fabriciogferreira/drone-with-esp2/Documentos/PRIMEIRO RELATÓRIO PARCIAL 2023.pdf

PRIMEIRO RELATÓRIO PARCIAL – PPD/2023 Envio até 15/05/2023

PPD/2023
Pesquisador:
Alunos bolsistas:
Alunos voluntários:
Colaboradores internos:
Colaboradores externos (incluir nome e instituição):
IDENTIFICAÇÃO DO PROJETO
Título: SIMULAÇÃO E CONTROLE DE ESTABILIDADE DE DRONES QUADRICÓPTEROS ATRAVÉS DE CONTROLE PID UTILIZANDO ARDUINO E ESP32
Área de Conhecimento:

( ) Ciências sociais e educação

( ) Biológicas e saúde

( X ) Agrárias, engenharias e tecnologia da informação.

COMITÊ DE ÉTICA EM PESQUISA COM HUMANOS (CEP) / COMITÊ DE ÉTICA

NO USO DE ANIMAIS (CEUA)

( ) Aprovado - CAAE: __________
( ) Em processo - CAAE: __________ ( ) Não enviado
( ) Não se aplica

1 – CRONOGRAMA DO PROJETO INICIAL

Conforme definido nas Tabelas 1 e 2, estão definidos em itens o cronograma proposto no

projeto entregue ao Programa de Pesquisa Docente 2023.

Este trabalho de pesquisa possui carácter interdisciplinar, onde iniciamos pelas

conceituações teóricas, análises matemáticas e desenvolvimento computacional, como forma de

definir e direcionar as sequências de opções mais adequadas e determinação de um melhor

resultado. Deste ponto em diante, os esforços estão na transposição das soluções teóricas e

virtuais para o sistema real, através das seguintes etapas:

a) Diagramação mecânica e cinemática da estrutura física do aeromodelo, suas características

sobre capacidade de sustentação e estabilidade.

Nesta etapa, o aluno deverá realizar o mapeamento de todas as variáveis do aeromodelo

tais como: peso dos componentes, peso do modelo completo, verificação da sustentação da

estrutura do quadricóptero por parte dos motores, velocidades mínimas e máximas atingidas.

Etapa concluída. Descrição na parte inicial do Desenvolvimento do Projeto.

b) Implementação do algoritmo de controle e sua utilização em plataforma de um grau de

liberdade.

Elaboração e implementação do algoritmo na plataforma Arduino e ESP-32 para controle

do protótipo com 1 grau de liberdade. Nesta etapa, utilizaremos somente 2 motores para a

estabilização.

Nesta etapa, foram implementados alguns algoritmos em C/C++ na plataforma Arduino para

controle dos motores.

c) Parametrização do algoritmo de interfaceamento sensores-microcontrolador.

Coleta dos valores dos parâmetros dos sensores do quadricóptero através da

implementação de algoritmo no Arduino e ESP-32.

d) Construção do circuito de desenvolvimento agregado ao microcontrolador, estrutura do

aeromodelo com quatro rotores e seus respectivos ESCs (Electronic Speed Controllers) e da

plataforma de teste para sustentação.

Elaboração e implementação do algoritmo na plataforma Arduino e ESP-32 para controle

do protótipo com 4 motores. Nesta etapa, utilizaremos os 4 motores para a estabilização e

definição do controle de velocidades.

e) Complementação da estrutura física para seus quatro rotores no modelo completo do

quadricóptero.

Construção do Chassi para agregação do circuito de controle, motores e sensores ao

quadricóptero.

f) Simulação em ambiente computacional e otimização das equações dinâmicas e seus

referentes coeficientes de ganho.

Mapeamento das variáveis para o equacionamento matemático do protótipo para a

estabilização através de controle PID.

g) Simulação em ambiente computacional, otimização do controle, seus referentes coeficientes

de ganho dos controladores.

Mapeamento das variáveis para otimização do controle do quadricóptero para a estabilização

e velocidade do modelo proposto.

h) Implementação do algoritmo de controle na plataforma do quadricóptero.

Implementação do programa em Arduino para o controle do quadricóptero em voo e

estabilização do conjunto proposto.

i) Análise de resultados e conclusão.

Apresentação dos resultados do projeto, da documentação da pesquisa e possíveis publicações

em congressos na área.

Tabela 1- Cronograma proposto no Projeto de Pesquisa Docente (Ano 1). ANO 1
Atividades | Fev. | Mar | Abr. | Mai | Jun. | Jul | Ago. | Set | Out | Nov. | Dez
a) Diagramação mecânica e cinemática da estrutura física do aeromodelo, suas características sobre capacidade de sustentação e estabilidade
b) Implementação do algoritmo de controle e sua utilização em plataforma de um grau de liberdade.
c) Parametrização do algoritmo de interfaceamento sensores-microcontrolador;
d) Construção do circuito de desenvolvimento agregado ao microcontrolador, estrutura do aeromodelo com quatro rotores e seus respectivos ESCs (Electronic Speed Controllers) e da plataforma de teste para sustentação.
e) Complementação da estrutura física para seus quatro rotores no modelo completo do quadricóptero;

Tabela 2 - Cronograma proposto no Projeto de Pesquisa Docente (Ano 2).

ANO 2

Atividades | Fev. | Mar | Abr. | Mai | Jun. | Jul | Ago. | Set | Out | Nov. | Dez
f) Simulação em ambiente computacional e otimização das equações dinâmicas e seus referentes coeficientes de ganho;
g) Simulação em ambiente computacional, otimização do controle, seus referentes coeficientes de ganho dos controladores;
h) Implementação do algoritmo de controle na plataforma do quadricóptero.
i) Análise de resultados e conclusão.

2 - HOUVE ALTERAÇÕES NO SEU PLANO DE TRABALHO (CRONOGRAMA)? QUAIS?
O cronograma inicial foi modificado devido a alteração do calendário proposto pelo Programa de Pesquisa Docente (PPD). As adaptações do novo cronograma estão definidas nas Tabelas 3 e 4.

Tabela 3- Cronograma modificado no Projeto de Pesquisa Docente (Ano 1).
ANO 1
Atividades | Fev. | Mar | Abr. | Mai | Jun. | Jul | Ago. | Set | Out | Nov. | Dez
a) Diagramação mecânica e cinemática da estrutura física do aeromodelo, suas características sobre capacidade de sustentação e estabilidade
b) Implementação do algoritmo de controle e sua utilização em plataforma de um grau de liberdade.
c) Parametrização do algoritmo de interfaceamento sensores-microcontrolador;
d) Construção do circuito de desenvolvimento agregado ao microcontrolador, estrutura do aeromodelo com quatro rotores e seus respectivos

ESCs | (Electronic | Speed
Controllers) e da plataforma de teste para sustentação.
e) | Complementação | da
estrutura física para seus quatro rotores no modelo
completo do quadricóptero;

Tabela 4- Cronograma modificado no Projeto de Pesquisa Docente (Ano 1). ANO 2
Atividades | Fev. | Mar | Abr. | Mai | Jun. | Jul | Ago. | Set | Out | Nov. | Dez
e) Complementação da estrutura física para seus quatro rotores no modelo completo do quadricóptero;
f) Simulação em ambiente computacional e otimização das equações dinâmicas e seus referentes coeficientes de ganho;
g) Simulação em ambiente computacional, otimização do controle, seus referentes coeficientes de ganho dos controladores;
h) Implementação do algoritmo de controle na plataforma do quadricóptero.
i) Análise de resultados e conclusão.

3 - ESTRUTURA DO RELATÓRIO, CONSIDERANDO O ART. 17º DO

REGULAMENTO DO PROGRAMA PESQUISADOR DOCENTE

A- INTRODUÇÃO

O município de Santa Fé do Sul está localizado extremo Noroeste Paulista, nas divisas de

Minas Gerais e Mato Grosso do Sul. Atualmente, o município é um dos 29 municípios paulistas

considerados estâncias turísticas, fortalecendo assim, a indústria do entretenimento, fazendo com

que milhares de turistas visitam a cidade todos os anos.

Santa Fé do Sul, também se encontra em uma das maiores regiões produtoras do setor

sucroalcooleiro e próxima ao Mato Grosso do Sul, hoje uma das maiores produtoras de papel e

celulose do país. Estas indústrias estão em crescente expansão e desenvolvimento, gerando

muitos empregos e riquezas para a região.

Para a supervisão e controle dos recursos turísticos, e plantio de cana-de-açúcar e

plantação eucalipto, da indústria de papel e celulose, podemos utilizar o monitoramento através

de Veículos Aéreos não Tripulados (VANTs) - drones.

Dada a crescente procura por derivados do setor sucroalcooleiro, como açúcar, etanol e

energia renovável, verifica-se a grande importância da cana-de-açúcar na economia brasileira. O

Brasil destaca-se como maior produtor mundial de cana-de-açúcar, com aproximadamente 640

milhões de toneladas processadas na safra de 2017/2018, de acordo com dados divulgados pela União da Indústria de Cana-de-Açúcar (ÚNICA, 2018), o que resultou em aproximadamente

38,69 milhões de toneladas de açúcar e 27,80 bilhões de litros de etanol para a agroindústria

sucroalcooleira (NOVACANA, 2017).

Com a expansão da cultura de cana-de-açúcar no país, aumentando eficiência,

produtividade e competitividade, e com o mercado sucroalcooleiro cada vez mais competitivo,

as usinas estão buscando novas alternativas para o desenvolvimento da produtividade agrícola,

de forma se estabelecer no mercado de forma competitiva.

Neste cenário de desenvolvimento da produtividade agrícola, os avanços em tecnologias

da informação e comunicação (TIC) estão cada vez mais presentes e sendo impactantes,

permitindo o armazenamento e processamento de grandes volumes de dados, automatização de processos e o intercâmbio de informações e de conhecimento (MASSRUHÁ; LEITE, 2016).

Observa-se atualmente uma forte relação do gerenciamento com a indústria 4.0, que representa

novos processos e produtos originados de avanços tecnológicos, com aplicações em várias áreas do conhecimento (SCHWAB, 2016; CONFEDERAÇÃO DA AGRICULTURA E PECUÁRIA

DO BRASIL, 2018).

Segundo Lopes (2018) e Simões; Soler; Py (2017), as transformações digitais também

chegaram nas atividades rurais, nas quais surge o termo agricultura 4.0, fortalecendo a ligação

urbano-rural nas suas diversas abordagens e permitindo dados cada vez mais precisos. A

agricultura 4.0 utiliza tecnologias de ponta na agricultura, incentivando processos na cadeia de

valor agregado da produção agrícola. Esta tecnologia pode ser uma importante revolução no

campo, tornando as lavouras mais eficientes e sustentáveis, bem como auxiliando a troca de informações e os processos com as empresas (SIMÕES; SOLER; PY, 2017).

As transformações digitais e a tecnologia aparecem no setor agrícola de várias formas. A

automação do processo, como da mão-de-obra, aconteceu com a ascensão de novas ferramentas, inovadoras e independentes (SIMÕES; SOLER; PY, 2017). Dentre os exemplos de tecnologias

e ferramentas utilizadas, encontram-se drones, caracterizados como os veículos aéreos não

tripulados (VANT), que são utilizados para monitoramento das lavouras, identificação de falhas

no plantio, entre outras atividades.

Segundo a Agência Nacional de Aviação Civil (ANAC, 2017), drones são aeronaves (ou

mesmo outro tipo de veículo) que possua alto grau de automatismo. A ANAC caracteriza as

aeronaves com finalidade comercial, corporativa ou experimental como Remotely Piloted

Aircraft (RPA - Aeronaves Remotamente Pilotadas).

O Sindicato Nacional das Empresas de Aviação Agrícola (SINDAG, 2017) supõem que

os drones serão substitutos de boa parte dos aparelhos de pulverização, trazendo precisão a

segurança na operação, ao mesmo tempo que coletam imagem em um raio maior do que seria

possível com acompanhamento da mão-de-obra na lavoura.

A tecnologias abortadas neste projeto são de interesse para a constante evolução das

indústrias do turismo, sucro-alcoleira e papel e celulose.

✓ JUSTIFICATIVA

A ênfase especial que os quadrimotores têm ganhado em cursos de Computação e

matérias de sistemas de controle robóticos, estendendo suas aplicações em usos militares, civis,

para observação, e até mapeamento de ambientes desconhecidos, é claramente justificável por

sua mobilidade aérea.

Para que um drone construído no formato de um quadrimotor possa realizar tarefas de

supervisão de ambiente torna-se necessário conhecer o posicionamento e orientação espacial,

para que o quadricóptero possa se movimentar neste ambiente.

Logo, a estabilidade do voo do quadricóptero é essencial para que ele possa ser utilizado,

impedindo que ele possa colapsar devido a uma forte corrente de vento, ou devido ao seu próprio

peso ou até mesmo devido informações com perturbações do empuxo resultante entre as hélices

do sistema. Para evitar estes problemas é necessário que se crie um sistema de controle capaz de

corrigir as variações devido às perturbações, reposicionando o drone na sua posição de equilíbrio com o menor tempo possível. O controle por PID (Proportional Integral Derivative -

Proporcional Derivativo e Integrativo) apresenta-se como uma solução de controle linear,

utilizado em várias aplicações na indústria de automação, sendo as vantagens deste método

segundo Leong (2012), possuir estrutura simples e bom desempenho.

Assim, tem-se como justificativa deste trabalho o estudo e confecção de um quadricóptero

com componentes comerciais, e a implementação de um algoritmo de controle computacional

baseado na teoria de sistemas lineares em um sistema dinâmico de estabilidade zero, como os

encontrados nos quadrimotores.

✓ PROBLEMATIZAÇÃO

Alguns estudos e trabalhos, como os de Beard (2008) e Zu, Zhang e Shan (2017),

dedicam-se à determinação de modelos matemáticos abrangentes e úteis aos problemas de

simulação e controle de quadrimotores. Outros, como o de Alves (2012) e Khatoon, Gupta e Das

(2014), dedicam-se ao estudo de técnicas para o controle deles, através do uso de técnicas de

controle lineares e não lineares.

Este trabalho se dedica ao desenvolvimento de estabilização de um drone com 4 motores,

envolvendo tanto o desenvolvimento de um protótipo, quanto a modelagem matemática dinâmica

do mesmo, o projeto dos controladores de estabilização de voo e o desenvolvimento do software

embarcado para controle do drone. Este trabalho também tem como objetivo ser open source, o

que permite sua replicação, e a um baixo custo, visto que os materiais utilizados foram

selecionados baseando-se em seus custos de mercado e nos requisitos mínimos impostos durante

a fase de desenvolvimento. O quadrimotor desenvolvido trata-se de um drone em formato de cruz

com dois pares de rotores que rotacionam em sentidos opostos a fim de eliminar os torques

gerados.

Diferentes controladores para a estabilização de voo de quadrimotores existem, lineares

e não lineares, este trabalho visa estabelecer um comparativo entre os resultados obtidos e

compará-los com os métodos já elaborados na literatura. Os controladores lineares desenvolvidos

utilizarão técnicas conhecidas como PID (Proportional Integral Derivative - Proporcional

Integral e Derivativo) (Ogata, 2011).

✓ OBJETIVOS

- OBJETIVO GERAL

Este trabalho de pesquisa tem por objetivo a construção completa de um protótipo

do tipo quadricóptero, implementar o controle dos sensores e o equacionamento de seu

algoritmo de controle PID, tornando o drone deste projeto, ser capaz de manter voo com a

melhor estabilidade.
- OBJETIVOS ESPECÍFICOS

Os objetivos específicos definidos na proposta deste trabalho são:

a) Levantamento e equacionamento dinâmico do VANT do tipo quadricóptero.
b) Construção de um algoritmo de controle em Arduino utilizando lei de controle

PID.

c) Construção da estrutura (chassi) do quadricóptero.
d) Aquisição e análise de dados pelos sensores utilizados.
e) Simulação utilizando os parâmetros do modelo desenvolvido.
f) Implementação do algoritmo de controle e aplicação no protótipo construído.

B – METODOLOGIA

Foram realizadas pesquisas em livros, artigos científicos e periódicos para conhecimento

e aprofundamento do tema.

Este trabalho de pesquisa possui carácter interdisciplinar, onde iniciamos pelas

conceituações teóricas, análises matemáticas e desenvolvimento computacional, como forma de

definir e direcionar as sequências de opções mais adequadas e determinação de um melhor

resultado. Deste ponto em diante, os esforços estão na transposição das soluções teóricas e

virtuais para o sistema real, através das seguintes etapas:

a) Diagramação mecânica e cinemática da estrutura física do aeromodelo, suas

características sobre capacidade de sustentação e estabilidade;

b) Implementação do algoritmo de controle e sua utilização em plataforma de um grau de

liberdade;

c) Parametrização do algoritmo de interfaceamento sensores-microcontrolador;

d) Construção do circuito de desenvolvimento agregado ao microcontrolador, estrutura

do aeromodelo com quatro rotores e seus respectivos ESCs (Electronic Speed Controllers

– Controladores Eletrônicos de Velocidade) e da plataforma de teste para sustentação;

e) Complementação da estrutura física para seus quatro rotores no modelo completo do

quadricóptero;

f) Simulação em ambiente computacional e otimização das equações dinâmicas e seus

referentes coeficientes de ganho;

g) Simulação em ambiente computacional, otimização do controle, seus referentes

coeficientes de ganho dos controladores;

h) Implementação do algoritmo de controle na plataforma do quadricóptero;
i) Análise de resultados e conclusão.
- MATERIAL | E | REQUISITOS | TÉCNICOS | NECESSÁRIOS | PARA | O

DESENVOLVIMENTO DO PROJETO

✓ MATERIAIS UTILIZADOS

Para a implementação do projeto foram utilizados softwares gratuitos e de código aberto

para o desenvolvimento da aplicação. Assim, não sendo necessários a aquisição de licenças

de softwares privados.

Para a confecção do drone da pesquisa, serão utilizados os seguintes componentes:

ESP32, ESP32-CAM, Módulo Giroscópio com Acelerômetro 3 eixos, 1 Bateria URUAV

11.1V Lipo, 4 Motores Brushless 2300 kV e 4 Placas ESC – 30 A. Todos os materiais já

foram adquiridos para a realização da pesquisa científica.
✓ REQUISITOS TÉCNICOS NECESSÁRIOS

Conhecimentos em Engenharia de Software, Programação de Computadores,

Arquitetura de Computadores, Matemática Básica e Física.

Este Projeto de Pesquisa Docente (PPD) deseja estudar e apresentar soluções relevantes

sobre a possibilidade de se aplicar o conhecimento adquiridos no curso de Análise e

Desenvolvimento de Sistemas, para o equacionamento, implementação e construção de um

quadricóptero de baixo custo.

Devido à complexidade da dinâmica envolvida no somatório de fenômenos físicos que

variam ao longo do tempo, pode-se perceber que o equacionamento de voo deste sistema,

depende de um controle de múltiplos níveis e não estacionário. Este tipo de planta, para ter

sua solução ótima, demanda da linearização do sistema e da implementação de um controle

robusto.

Algumas literaturas recentes, citam técnicas de inteligência artificial, como

possibilidades de soluções que poderiam alcançar a adaptação necessária ao controle de um

sistema que possui variação de parâmetros e equações em função do tempo. Sistemas que

utilizam técnicas que realizam o recálculo de seus parâmetros, e que as reutilizam como

forma de aprendizado, têm maiores chances de alcançar o controle eficaz de um sistema não

estacionário. Estas técnicas de programação podem ser exemplificadas pelo estudo das redes

neurais, nebulosas, grafos, genéticos e Fuzzy, como descrito por este artigo da Universidade

do Tehran:

Embora o quadrirotor tenha vantagens em uma construção mecânica fácil contra o

helicóptero tradicional, ainda há questões que impedem que ele seja amplamente utilizado

em muitos dos campos sugeridos de aplicação. Por exemplo, o controle e orientação do

quadrirotor para estabilização, é uma tarefa difícil, devido ao comportamento dinâmico não

linear. Métodos de controle convencionais usam teoria linear que é adequado apenas para

sistemas lineares. O controle Fuzzy é não-linear, portanto, é adequado para o controle do

sistema não-linear (ABBASI; MAHJOOB; YAZDANPANAH, 2013).

Contudo, algoritmos metaheuríticos (como por exemplo Algoritmos Evolutivos ou

Genéticos) atuam em espaços de busca relativamente grandes e exigem alta precisão no

computar das operações, para muitos casos. Nos casos de algoritmos de inteligência artificial,

o problema de custo computacional (processamento) é ainda maior, já que as operações são

computacionalmente intensas e exigem altas taxas de leitura e escrita em memória. Esse

poder computacional não é totalmente disponível nos processadores e sistemas de

embarcados em VANTs. Além disso, operações computacionalmente intensas aumentam o

consumo de energia diminuindo a autonomia de voo.

Assim, existem várias formas de se controlar a estrutura PID original, de forma que estas

também podem reagir e se adaptarem às mudanças do ambiente em que se encontra. A técnica

Feedforward de PID pode ser empregada com este intuito, em um sistema que seja possível variar

o sinal de controle em um tempo menor que o tempo que um distúrbio leva para afetar a saída,

quantificar os distúrbios do sistema e, os efeitos desses distúrbios na resposta depois das análises

dos sensores. Assim, este trabalho tem por objetivo, implementar um algoritmo em Arduino e

ESP-32 utilizando o controle PID de forma a viabilizar a estabilização do voo de um drone.

C – DESENVOLVIMENTO DO PROJETO
1 - CONSIDERAÇÕES INICIAIS

Os drones usam rotores para propulsão e controle. Eles foram projetados de forma que as

hélices empurram o ar para baixo. Como as forças vêm em pares, quando o rotor empurra o ar

para baixo, o mesmo ar empurra o drone para cima. Assim, quanto mais rápido os rotores giram,

maior será a força gerada para subir (ZARDO; REIS; WEBBER, 2021).

Um drone pode executar ações úteis para a compreensão dos fenômenos físicos

relacionados a força gravitacional, movimento, aceleração, inércia e rotação. Para exemplificar,

a física do drone funciona com os quatro rotores, que estão empurrando o drone para cima,

igualando-se à força gravitacional. Para subir, a velocidade dos rotores deve ser aumentada,

produzindo uma força ascendente maior que o peso do próprio drone.

Para descer, deve-se diminuir o impulso aos poucos para que a força da gravidade

empurre o drone para baixo. Para os movimentos de deslocamento e rotação, os rotores precisam

ser coordenados para atuarem em diferentes velocidades, gerando os movimentos desejados do

protótipo elaborado (ZARDO; REIS; WEBBER, 2021).

- Movimentação Vertical: Os motores são separados da seguinte forma: Sendo

que os motores 1-3 sempre rodando em sentido horário e os motores 2-4 em

sentido anti-horário. Com os motores rodando as hélices na mesma velocidade e

com as rotações dessa forma, o momento angular do drone será completamente 0,

como pode observar na Figura 1, (BRAGA, 2013).

Figura 1 – Posição de rotação dos motores

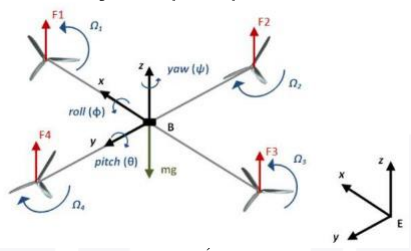
[picture p1: figure]

Fonte: (SÁ, 2012).

- Movimentação: Para a movimentação para frente, a força dos motores Traseiros

(3 e 4) tem que aumentar enquanto a força de rotação dos Dianteiros (1 e 2) tem

que diminuir. Para ele se movimentar para trás o mesmo processo com as forças

invertidas, sendo os traseiros os mais fracos, e os mais fortes, os dianteiros. Pelo

fato dos motores traseiros e dianteiros serem um com rotação horário e um anti-

horário, o momento angular do drone continua sendo 0, porém podendo ir para

frente ou trás, sem rodar (BRAGA, 2013).

Na Figura 1 são ilustrados os movimentos possíveis, nela a largura da seta é proporcional

à velocidade dos rotores. Os motores 1 e 3 giram em sentido anti-horário e os motores 2 e 4 giram

em sentido horário (MIRANDA, 2019).

Fixando a velocidade dos motores 2 e 4 e aumentando a velocidade do motor 3 em relação

a velocidade do motor 1 o quadrimotor se move para frete, como mostrado na Figura 2. O

contrário ocorre quando a velocidade do motor 3 é maior que a velocidade do motor 1, Figura 2

(b). Os movimentos para direita e esquerda ocorrem quando a velocidade dos motores 1 e 3

permanece a mesma e a velocidade do motor 2 varia em relação a velocidade do motor 4, Figura

2 (c) e 2 (d) (MIRANDA, 2019).

Figura 2 – Posição de rotação dos motores

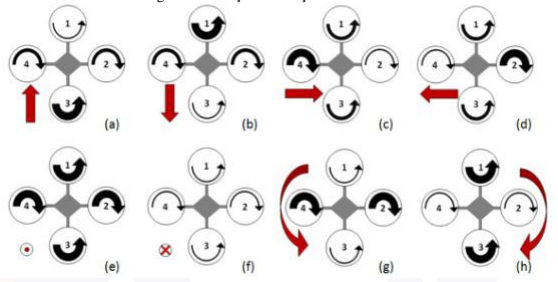
[picture p2: figure]

Fonte: (SÁ, 2012)

O aumento ou a diminuição da velocidade igualmente nos quatro motores faz com que o

quadrirotor se mova verticalmente. De acordo com Sá (2012), com o aumento simultâneo de

todas as velocidades angulares dos rotores o quadrirotor se move para cima e a diminuição

simultânea de todas as velocidades faz com que se mova para baixo, conforme Figura 1 e 2.

A variação de dois rotores situados no mesmo eixo produz um torque em torno do eixo

gerando uma aceleração angular. Então, se os dois rotores que giram em sentido anti-horário

(rotores 1 e 3) aumentarem suas velocidades angulares e os rotores 2 e 4 permanecessem com

velocidade menor, o torque produzido na plataforma faria com que ele gire em sentido horário,

como mostrado na Figura 2(h). O contrário ocorreria se aumentassem os rotores 2 e 4 em relação

aos rotores 1 e 3, Figura 2 (g).

1.1 – CÁLCULO PID

Para manter a estabilidade do drone no ar, é de extrema importância utilizar um cálculo

PID para atualizar os valores de potência dos motores automaticamente, assim o piloto gozará de

maior liberdade no controle do VANT. O cálculo PID é relativamente simples, funcionando da

seguinte forma:

- P - representa o valor proporcional, simplificando seria o valor que controla a potência

de reação dos motores, o que faz o drone sair do chão.

- I - representa o valor integral, simplificando é a intolerância ao desnível, onde a leitura

da posição atual é diferente da do valor esperado (setpoint), forçando o motor a trabalhar para

alcançar a estabilidade.

- D - representa o valor derivativo, sua função é desacelerar o valor proporcional quando

estiver se aproximando do setpoint, para assim não ultrapassar o valor inicial, evitando o

fenômeno conhecido como overshoot, um erro de divergência que atrasa a correção do valor da

posição.

Para melhor visualização do funcionamento do cálculo, observe a Figura 3, que utiliza os

dados obtidos através do giroscópio para o controle, em seguida analisa as diferenças entre eles

e o setpoint, sendo este valor o erro “e(t)”, que é utilizado nas equações representadas resultando

no sinal de controle “u(t)”, este sinal de controle por sua vez será utilizado no controle de

processo utilizando uma representação matemática do sistema, normalmente diferencial, para só

assim controlar o processo e alcançar o valor desejado para a saída “y” (setpoint). Por fim, a

saída do processo lida mediante a malha de realimentação “y” é subtraída do setpoint resultando

no sinal de erro “e(t)”, resultando assim em um looping que constantemente corrige a posição do

drone, mantendo assim a estabilidade aérea.

Todas as informações descritas estão de acordo com Anon (2016a), consta com

adaptações no projeto feitas pelos próprios autores para melhor compreensão do leitor.

Figura 3 – Alimentação e conexão da controladora com os ESCs

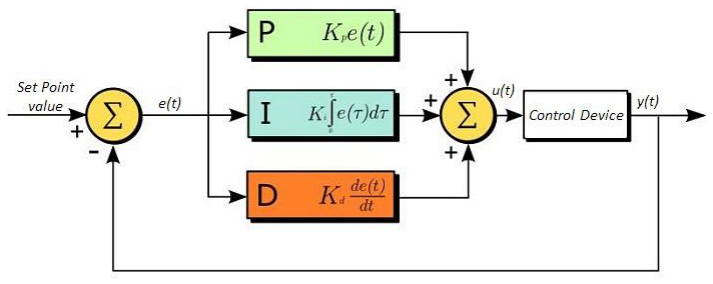
[picture p3: figure]

Fonte: (ANON, 2016b)

Na primeira etapa do projeto, optou-se pela aquisição de um chassi pronto, conforme

apresentado na Figura 4.

Figura 4 – Chassi do Drone

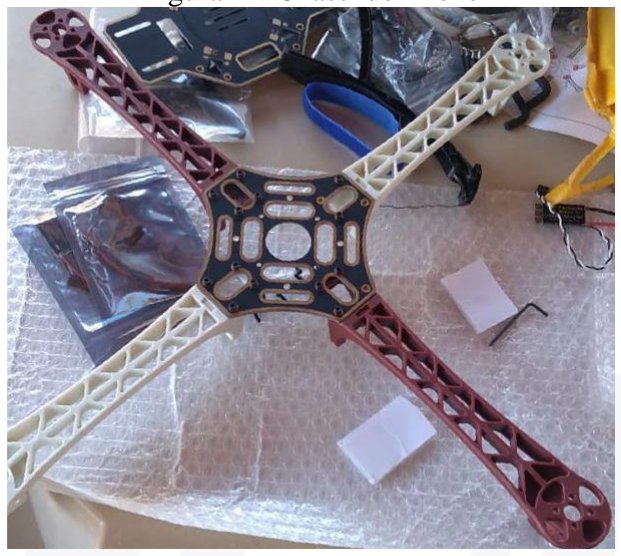
[picture p4: figure]

Fonte: Próprios autores.

Com a chegada das peças iniciou-se o processo de montagem do drone físico, para assim dar

início aos testes que os programas carecem. Primeiramente, montou-se o chassi de acordo com

o mapa fornecido pelo vendedor, como é apresentado na Figura 4. Em seguida, foram soldados

os componentes e feito teste de continuidade com o multímetro para verificar se alguma trilha da

placa estava corrompida como mostra a Figura 5.

Figura 5 – Soldagem dos Motores e Conector da Bateria

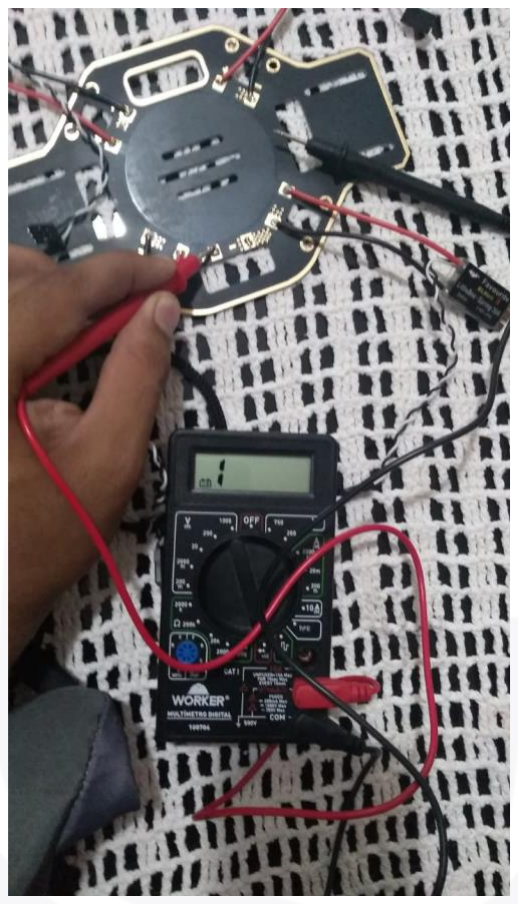
[picture p5: figure]

Fonte: Próprios autores.

Finalizado a etapa de pesquisas e compras, iniciou-se os testes de software e hardware,

para assim constatar se a comunicação estava funcionando e o controle cumprindo com suas

obrigações, o teste foi concluído com êxito onde se vê claramente o trabalho de sintonia entre a

parte lógica e física do projeto.

1.2 - PLACA PCB COM INTERRUPTOR

Foi adaptado um interruptor ao chassi, o prendendo com cola quente, isto foi feito com o

intuito de permitir ligar e desligar o drone para testes de forma mais rápida e simples, pois, se

isso não fosse feito, teríamos que sempre ficar conectando e desconectando os pinos macho e

fêmea do conector XT60. Mesmo sendo um interruptor de boa qualidade estando desligado ele

permite que passe uma tensão de aproximadamente de 0.8V, por conta disso, quando os testes forem parados é aconselhável desconectar o pino da bateria do pino do chassi, como pode-se

observar na Figura 6.

Figura 6 – Adaptação do Botão Tic-Tac

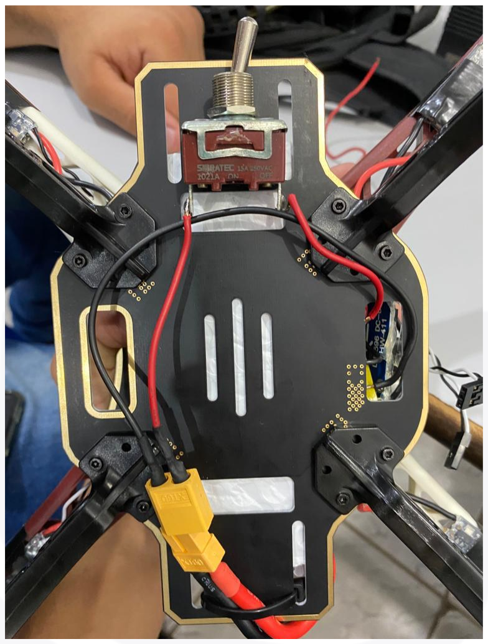
[picture p6: figure]

Fonte: Próprios autores.

1.3 - BRAÇO COM MOTOR E ESC

Neste braço, como nos outros, foi preso em sua ponta um motor sem escova rs2205

2300kv 2205 cW/ccW, ele foi preso com parafusos que vieram junto com o conjunto do chassi

que compõem o módulo. Para fazer o controle desse tipo de motor precisamos utilizar um ESC

(Eletronic Speed Controller, Controlador Eletrônico de Velocidade) o qual foi preso na parte de

baixo do braço com seus terminais soldados na placa de baixo do chassi - placa PCB (Printed

Circuit Board - Placa de Circuito Impresso) onde estão presos os pés do drone – e seus pinos de

controle, onde será recebido o pulso PWM (Pulse Width Modulation – Modulação com largura

de pulso), será preso na placa de controle, como pode-se observar na Figura 7.

Figura 7 – Braço com Motor e ESC

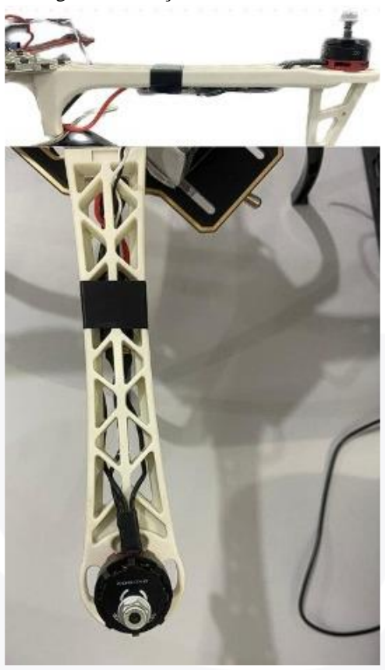
[picture p7: figure]

Fonte: Próprios autores.

1.4 - FIXAÇÃO DAS PLACAS AO CHASSI
Para terminar a montagem do drone em si, bastava anexar a placa de controle e o servidor

web ESP32-CAM ao drone. Portanto, para o ESP32-CAM foi utilizado fita dupla face e uma

cinta de velcro azul que veio junto com a compra do chassi. Já para colocar a placa de controle

foi utilizado fita dupla face e para evitar o contato da parte eletrônica que fica embaixo da placa

de controle com a parte metálica do chassi, foi anexado entre ambos um pedaço de papelão –

preso à placa com cola quente – e preso ao papelão a dupla face que o fixou ao chassi, como pode

observar nas Figuras 8 e 9.

Figura 8 – Fixação das hélices | Figura 9 – Fixação das placas ao Chassi

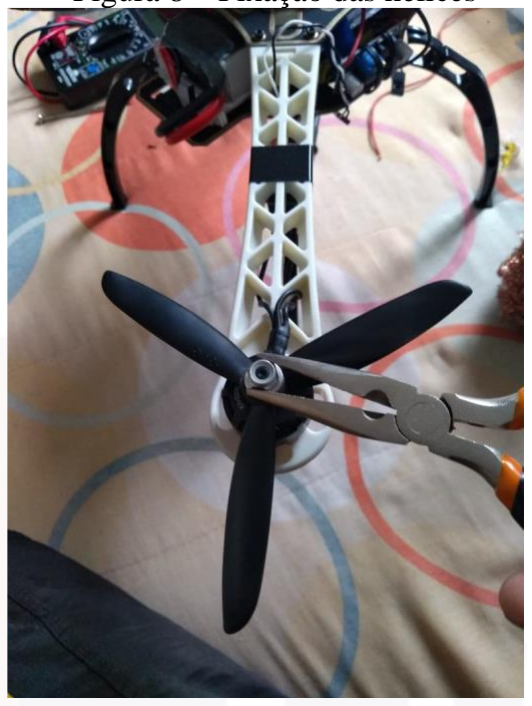
[picture p8: figure]
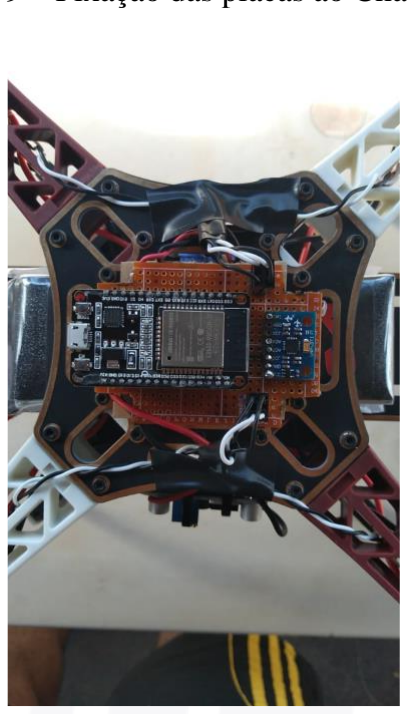
[picture p9: figure]

Fonte: Próprios autores.

1.5 - ALIMENTAÇÃO E CONEXÃO DA CONTROLADORA COM OS ESCS

Após prender as duas placas foi realizado a parte de alimentação de ambas, onde foi

soldado a placa os terminais de saída do regulador de tensão que envia para placa uma tensão de

5V. Da placa, a energia é enviada para o ESP32 – por meio de fios soldados aos terminais GND

e VIN – e para o ESP32-CAM – conectado a um cabo micro-usb que tem seus terminais

conectados aos pinos GND e VIN do ESP32. Também foi feita a conexão entre a placa de

controle e os ESCs, onde cada pino de entrada de dados de cada ESC foi colocado em cada

terminal específico, como pode observar a Figura 10.

Figura 10 – Alimentação e conexão da controladora com os ESCs

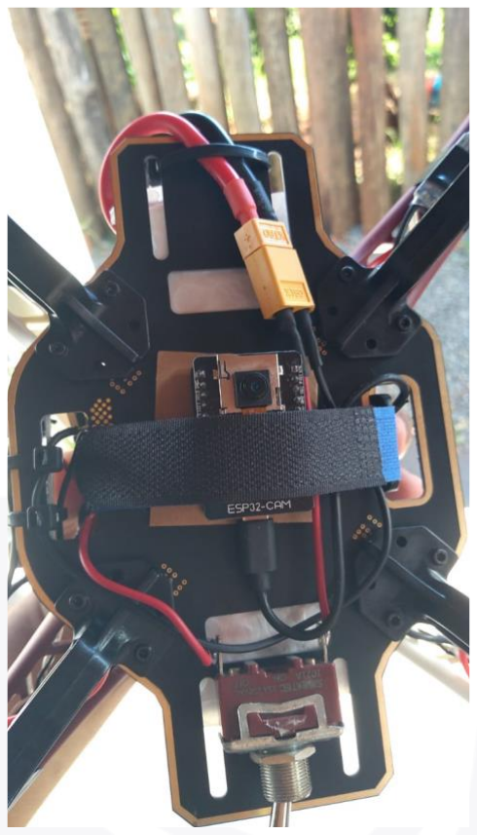
[picture p10: figure]

Fonte: Próprios autores.

1.6 – CONSIDERAÇÕES FINAIS

No próximo relatório dar-se-á ênfase os algoritmos e componentes eletrônicos utilizados na

etapa (b) do cronograma. A junção dos itens propostos no cronograma deste relatório, definirá a

composição do texto desta pesquisa científica.

REFERÊNCIAS BIBILIOGRÁFICAS

ABBASI E.; MAHJOOB M. J.; YAZDANPANAH R. Controlling of Quadrirotor UAV Using a Fuzzy System for Tuning the PID Gains in Hovering Mode. School of Mechanical Engineering, University of Tehran, Iran, 2013.

ALVES, Ana Sophia Cavalcanti. Estudo e Aplicação de Técnicas de Controle Embarcadas para Estabilização de Voo de Quadricópteros, 2012, 121 f. Tese (Doutorado em Engenharia Elétrica) – Universidade Federal de Juiz de Fora.

ANAC, 2017. Regras sobre drones. Disponível em: http://www.anac.gov.br/noticias/2017/regras-da-anac-para-uso-de-drones-entram-em-vigor/release_drone.pdf. Acesso em: 20 de Dez. 2022.

ANON. Controlador PID. Você sabe o que é e como funciona? Aula 01 - Teoria. 2016. Url https://www.youtube.com/watch?v=MPkEPvs8rec.

ANON. CONTROLADORES PID. 2016. Url https://smarti.blog.br/controladores-pid/.

BEARD, R. W. Quadrotor Dynamics and Control, 2008.

BRAGA, A. P. Simulação e controle de um quadcopter utilizando lógica fuzzy. Universidade Estadual Paulista (Unesp), 2013.

KHATOON, S; GUPTA, D.; DAS, L. K. PID & LQR Control for a Quadrotor: Modeling and Simulation, IEEE Robotics & Automation Magazine, 2014.

LEONG, Bernard Tat Meng; LOW, Sew Ming; OOI, Melanie Po-Leen. Low-Cost Microcontroller-based Hover Control Design of a Quadcopter. Procedia Engineering. V. 41,
p. 458-464, 2012.

LOPES, M. A. Agricultura 4.0: o agronegócio também na rota do desenvolvimento tecnológico. 2018. Disponível em: https://www.techminds.info/2018/05/10/agricultura-4-0-oagronegocio-tambem-na-rota-do-desenvolvimento-tecnologico. Acesso em: 02 de Jan. 2023.

MASSRUHÁ, S. M. F. S.; LEITE, M. A. A. Agricultura Digital. RECoDAF – Revista Eletrônica Competências Digitais para Agricultura Familiar, Tupã, v. 2, n. 1, p. 72-88, jan./jun. 2016.

MIRANDA, B. d. A. S. Montagem de uma plataforma para testes de controle de um veículo aéreo não tripulado quadrimotor. Dissertação (B.S. thesis) — Universidade Tecnológica Federal do Paraná, 2019.

NOVACANA, 2017. Conab divulga dados finais de 2016/17 e 1º levantamento da safra 2017/18 de cana-de-açúcar. Disponível em: https://www.novacana.com/n/cana/safra/conabdados-finais-2016-17-levantamento-safra-2017-18-cana-de-acucar-180417/. Acesso em: 10 Jan. 2023.

OGATA, K. Engenharia de Controle Moderno. 5th ed. 2011.

SÁ, R. C. Construção, modelagem dinâmica e controle PID para estabilidade de um veículo aéreo não tripulado do tipo quadrirotor. 2012.

SCHWAB, K. The Fourth Industrial Revolution, WEF, 2016.

SIMÕES, M.; SOLER, L; S.; PY, H. Tecnologias a serviço da sustentabilidade e da agricultura. Boletim informativo da SBCS. Mai-ago, 2017.

SINDAG, 2017. Relatório de Atividades – Brasil 2016. Disponível em: http://sindag.org.br/wp-content/uploads/2016/12/SINDAG-Relatorio-de-Atividades-Abril2016.pdf.

UNICA, 2018. Relatório final da safra 2017/2018. Disponível em: http://www.unicadata.com.br/listagem.php?idMn=102.

ZARDO, M.; REIS, C. E. R. dos; WEBBER, C. G. Como um drone voa? descubra na aula de física! RENOTE, v. 19, n. 2, p. 292–301, 2021.

ZU, Y.; ZHANG, W.; SHAN J. A trajectory design method for quadrotor based on DMOC method and Dubins path algorithm, 36th Chinese Control Conference, 2017.
