fabriciogferreira/drone-with-esp2/Códigos/Control/Control.ino

//===================================================================================
//====================================|VARIABLES|====================================
//===================================================================================
//------------------------------------|LIBRARIES|------------------------------------
  #include <WiFi.h>
  #include <Wire.h>
  #include <esp_now.h>
  #include <SPI.h>
  #include <Adafruit_GFX.h>
  #include <Adafruit_SSD1306.h>

//----------------------------------|COMUNICATION|-----------------------------------
  struct ControlData {
    int dof[3];
    int throttle;
    volatile bool flightMode;
  };

  ControlData controlData = {{0, 0, 0}, 0, true};

  struct DroneData {
    enum Errors {
      NOT_ERROR = 0,
      MPU6050_ERROR = 1,
    };

    Errors error;
    unsigned int speed;
    float angles[3];
    float pwmSignalInUs[4];
    float angularVelocities[3];
  };

  DroneData droneData = {DroneData::NOT_ERROR, 0, {0, 0, 0}, {0, 0, 0, 0}, {0, 0, 0}};

  const uint8_t SLAVES_MAC_ADDRESSES[][6] = {
    // { 0xCC, 0xDB, 0xA7, 0x30, 0x46, 0x34 }  //Mac address do meu ESP32 para o drone
    { 0xD0, 0xEF, 0x76, 0x33, 0x33, 0xC0 }  //Mac address do ESP32 do professor para o drone
  };

  const unsigned int CHANNEL = 1;  //Canal do slave
  const unsigned int AMOUNT_OF_SLAVES = sizeof(SLAVES_MAC_ADDRESSES) / 6; //Quantidade de ESP Escravos, os que vão receber dados

//-------------------------------------|DISPLAY|-------------------------------------
  #define SCREEN_WIDTH 128 // OLED display width, in pixels
  #define SCREEN_HEIGHT 64 // OLED display height, in pixels

  // Declaration for an SSD1306 display connected to I2C (SDA, SCL pins)
  // The pins for I2C are defined by the Wire-library. 
  #define OLED_RESET     -1 // Reset pin # (or -1 if sharing Arduino reset pin)
  #define SCREEN_ADDRESS 0x3C ///< See datasheet for Address; 0x3D for 128x64, 0x3C for 128x32
  Adafruit_SSD1306 Display(SCREEN_WIDTH, SCREEN_HEIGHT, &Wire, OLED_RESET);

//-------------------------------------|CONTROL|-------------------------------------
  //DOF = Degrees Of Freedom
  //J1x, J1y, J1z, J2x, J2y, J2z
  const unsigned int PIN_YAW = 35;
  const unsigned int PIN_THROTTLE = 34;
  const unsigned int PIN_J1Z = 25;
  const unsigned int PIN_ROLL = 33;
  const unsigned int PIN_PITCH = 32;
  const unsigned int PIN_J2Z = 26;

  const unsigned int *PT_PINS_XY_JS[] = {&PIN_YAW, &PIN_THROTTLE, &PIN_ROLL, &PIN_PITCH};
  const int MIN_SETPOINTS[] = {-30, 950, -30, 30};
  const int MID_SETPOINTS[] = {0, 1525, 0, 0};
  const int MAX_SETPOINTS[] = {30, 1800, 30, -30};
  unsigned int maxRangeOfJoystickAxes[] = {0, 0, 0, 0};
  unsigned int midRangeOfJoystickAxes[] = {0, 0, 0, 0};
  unsigned int minRangeOfJoystickAxes[] = {UINT_MAX, UINT_MAX, UINT_MAX, UINT_MAX};
  const unsigned int JOYSTICK_AXIS_DEAD_ZONE_RATES[] = {10, 10, 10, 10};
  unsigned int joystickAxisDeadZones[] = {0, 0, 0, 0};

  int *SetPoints[] = {&controlData.dof[0], &controlData.throttle, &controlData.dof[1], &controlData.dof[2]};

  int pinJ1ZState = HIGH;            // DEVE SER O VALOR CONSTANTE DO BOTÃO
  int lastPinJ1ZState = pinJ1ZState; 
  unsigned long j1ZLastDebounceTime = 0;  // the last time the output pin was toggled
  const unsigned int J1Z_DEBOUNCE_DELAY = 50;

  int pinJ2ZState = HIGH;            // DEVE SER O VALOR CONSTANTE DO BOTÃO
  int lastPinJ2ZState = pinJ2ZState; 
  unsigned long j2ZLastDebounceTime = 0;  // the last time the output pin was toggled
  const unsigned int J2Z_DEBOUNCE_DELAY = 50;

//--------------------------------------|UTILS|--------------------------------------
  bool stop = true;
//===================================================================================
//======================================|CODE|=======================================
//===================================================================================
//--------------------------------------|UTILS|--------------------------------------
  template<typename T, int N>
  int getArraySize(T (&array)[N]) {
    return N;
  }

  void printOnDisplay(String text, bool resetCursor = NULL, int delayTime = 0, bool clearDisplay = NULL){
    if (clearDisplay) Display.clearDisplay();
    if (resetCursor) Display.setCursor(0,0);
    Display.println(text);
    Display.display();
    if (delayTime) delay(delayTime);
  }

void startSerial(){
  Serial.begin(115200);
}

void configDisplay(){
  Display.begin(SSD1306_SWITCHCAPVCC, SCREEN_ADDRESS);
  Display.setCursor(0,0);
  Display.setTextSize(1);
  Display.setTextColor(SSD1306_WHITE);
  Display.clearDisplay();
}

void configJoystick(){
  printOnDisplay("Configurando joysticks", true, 1000, true);
  for (int i = 0; i < getArraySize(PT_PINS_XY_JS); i++) {
    pinMode(*PT_PINS_XY_JS[i], INPUT);
  }

  pinMode(PIN_J2Z, INPUT);
}

void readJ1Z(){
  int state = digitalRead(PIN_J1Z);
  
  if (state != lastPinJ1ZState) {
    j1ZLastDebounceTime = millis();
  }

  if ((millis() - j1ZLastDebounceTime) > J1Z_DEBOUNCE_DELAY) {
    if (state != pinJ1ZState) {
      pinJ1ZState = state;
      if (pinJ1ZState == HIGH) controlData.flightMode = !controlData.flightMode;
    }
  }

  lastPinJ1ZState = state;
}

void readJ2Z(){
  int state = digitalRead(PIN_J2Z);

  if (state != lastPinJ2ZState) {
    j2ZLastDebounceTime = millis();
  }

  if ((millis() - j2ZLastDebounceTime) > J2Z_DEBOUNCE_DELAY) {
    if (state != pinJ2ZState) {
      pinJ2ZState = state;
      if (pinJ2ZState == HIGH) { stop = !stop;}
    }
  }

  lastPinJ2ZState = state;
}

void stopUntilPressToContinue(String text){
  printOnDisplay(text);

  while (stop){
    readJ2Z();
  };
}

void resetStop(){
  stop = true;
}

void getRangeOfJoystickAxes(){
  printOnDisplay("Mova os joysticks em todas as direções", true, 0, true);

  stopUntilPressToContinue("Aperte R3 para prosseguir");

  resetStop();

  int value = 0;

  do{
    Display.clearDisplay();
    Display.setCursor(0,0);

    for (int i = 0; i < getArraySize(PT_PINS_XY_JS); i++) {
      value = analogRead(*PT_PINS_XY_JS[i]);
      if(value > maxRangeOfJoystickAxes[i]){
        maxRangeOfJoystickAxes[i] = value;
      } else if (value < minRangeOfJoystickAxes[i]) {
        minRangeOfJoystickAxes[i] = value;
      }

      printOnDisplay(String(*PT_PINS_XY_JS[i]) + ": " + String(minRangeOfJoystickAxes[i]) + " - " + String(maxRangeOfJoystickAxes[i]));
    }
    
    readJ2Z();
  }while(stop);
}

void getAverageOfJoystickAxes(){
  printOnDisplay("Calculando o meio dos eixos dos joysticks", true, 0, true);

  int max = 3000;
  for (int i = 0; i < max; i++) {
    for (int j = 0; j < getArraySize(PT_PINS_XY_JS); j++) {
      midRangeOfJoystickAxes[j] = midRangeOfJoystickAxes[j] + analogRead(*PT_PINS_XY_JS[j]);
    }
    // delayMicroseconds(20);
  }

  for (int i = 0; i < 4; i++) {
    midRangeOfJoystickAxes[i] = midRangeOfJoystickAxes[i]/max;
    printOnDisplay(String(*PT_PINS_XY_JS[i]) + ": " + String(midRangeOfJoystickAxes[i]));
  }
}

void getDeadZonesOfJoystickAxes(){
  printOnDisplay("Deadzone dos eixos dos joysticks", true, 0, true);

  for (int i = 0; i < 4; i++) {
    joystickAxisDeadZones[i] = JOYSTICK_AXIS_DEAD_ZONE_RATES[i] * midRangeOfJoystickAxes[i] / 100;

    printOnDisplay(String(*PT_PINS_XY_JS[i]) + ": " + String(midRangeOfJoystickAxes[i] - joystickAxisDeadZones[i]) + " - " + String(midRangeOfJoystickAxes[i] + joystickAxisDeadZones[i]));
  }
}

void startStationMode() {
  WiFi.mode(WIFI_STA);

  printOnDisplay("Inicializando o modo station", true, 0, true);
  printOnDisplay("Mac Address desse ESP em Station: " + WiFi.macAddress());
}

void startEspNow() {
  bool Result = esp_now_init() == ESP_OK;

  String message = Result ? "ESPNow iniciado com sucesso." : "Não foi possível iniciar o ESPNow.";
  
  printOnDisplay(message, true, 0, true);

  if (!Result) {ESP.restart();}
}

void registerFunctionThatExecutesWhenReceivingResponse(){
  esp_now_register_send_cb(WhenReceivingResponseDo);
}

void registerFunctionThatExecutesWhenReceivingData(){
  esp_now_register_recv_cb(WhenReceivingDataDo);
}

void establishConnectionBetweenESPs(){
  printOnDisplay("Configurando Master (Mestre) e Escravos (Slaves)...", true, 500, true);

  for (int i = 0; i < AMOUNT_OF_SLAVES; i++) {
    esp_now_peer_info_t Slave = {};
    Slave.channel = CHANNEL;
    Slave.encrypt = 0;
    memcpy(Slave.peer_addr, SLAVES_MAC_ADDRESSES[i], sizeof(SLAVES_MAC_ADDRESSES[i]));
    esp_now_add_peer(&Slave);
  }
}

void configButtonJoystick(){
  pinMode(PIN_J1Z, INPUT); // é necessário configurar depois do startStationMode, não sei o motivo
}

void sendDataEspDrone() {
  esp_now_send(SLAVES_MAC_ADDRESSES[0], (uint8_t *) &controlData, sizeof(controlData));
}

void calculatePackageValues() {
  int value = 0;
  for (int i = 0; i < getArraySize(PT_PINS_XY_JS); i++) {  
    value = analogRead(*PT_PINS_XY_JS[i]);
    value = constrain(value, minRangeOfJoystickAxes[i], maxRangeOfJoystickAxes[i]);
    if (value <= midRangeOfJoystickAxes[i] - joystickAxisDeadZones[i]) {
      *SetPoints[i] = map(value, minRangeOfJoystickAxes[i], midRangeOfJoystickAxes[i] - joystickAxisDeadZones[i], MIN_SETPOINTS[i], MID_SETPOINTS[i]);
    } else if (value >= midRangeOfJoystickAxes[i] + joystickAxisDeadZones[i]) {
      *SetPoints[i] = map(value, midRangeOfJoystickAxes[i] + joystickAxisDeadZones[i], maxRangeOfJoystickAxes[i], MID_SETPOINTS[i], MAX_SETPOINTS[i]);
    } else {
      *SetPoints[i] = MID_SETPOINTS[i];
    }
  }
}

void checkDrone(){
  switch (droneData.error) {
    case DroneData::MPU6050_ERROR:
      printOnDisplay("O MMPU6050 apresentou erro", true, 0, true);
      break;
    case DroneData::NOT_ERROR:
      break;
    default:
      printOnDisplay("Erro desconhecido", true, 0, true);
      break;
  }
}

void setup() {
  startSerial();
  configDisplay();
  configJoystick();
  getRangeOfJoystickAxes();
  getAverageOfJoystickAxes();
  getDeadZonesOfJoystickAxes();
  startStationMode();
  configButtonJoystick();
  startEspNow();
  registerFunctionThatExecutesWhenReceivingResponse();
  registerFunctionThatExecutesWhenReceivingData();
  establishConnectionBetweenESPs();
  sendDataEspDrone();
}

void WhenReceivingResponseDo(const uint8_t *MAC_ADDRESS,  esp_now_send_status_t response) {
  calculatePackageValues();
  // delay(1000);
  checkDrone();
  sendDataEspDrone();
}

void WhenReceivingDataDo(const esp_now_recv_info_t *MAC_ADDRESS, const uint8_t *DRONE_DATA, const int DATA_SIZE) {
  memcpy(&droneData, DRONE_DATA, sizeof(droneData));

  // Serial.print("Yaw: " + String(controlData.dof[0]));
  // Serial.print("\t");
  
  // Serial.print("Roll: " + String(controlData.dof[1]));
  // Serial.print("\t");

  // Serial.print("Pitch: " + String(controlData.dof[2]));
  // Serial.print("\t");

  // Serial.print("Throttle: " + String(controlData.throttle));
  // Serial.print("\t");

  // Serial.print("Flight Mode: " + String(controlData.flightMode));
  // Serial.print("\t");

  Serial.print(droneData.speed);
  Serial.print("\t");

  for (int i = 0; i < 3; i++) {
    Serial.print(droneData.angles[i]);
    Serial.print("\t");
  }

  for (int i = 0; i < 4; i++) {
    Serial.print(droneData.pwmSignalInUs[i]);
    Serial.print("\t");
  }

  for (int i = 0; i < 3; i++) {
    Serial.print(droneData.angularVelocities[i]);
    Serial.print("\t");
  }

  Serial.println();
}

void loop() {
  readJ1Z();
}
