fabriciogferreira/drone-with-esp2/(commit log)

2024-08-06 feat: connection and swap data between esps
    [NewDrone.ino, sketch_jul19a.ino]
2024-08-18 fix: debounce for stop code
    [sketch_jul19a.ino]
2024-08-18 fix: rename properties package
    [NewDrone.ino]
2024-08-18 fix: remove pin
2024-08-18 fix: functions to camelCase
    [NewDrone.ino, sketch_jul19a.ino]
2024-08-19 fix: reorder and rename variables
    [sketch_jul19a.ino]
2024-08-20 feat: send enum error and check
    [NewDrone.ino, sketch_jul19a.ino]
2024-08-24 feat: average acc and gyro data
2024-08-25 fix: delay od 1 sec
    [sketch_jul19a.ino]
2024-08-25 fix: ports adc2 unable when wifi is active
    [sketch_jul19a.ino]
2024-08-25 fix: rename setppoint to value in calculate package values
    [sketch_jul19a.ino]
2024-08-25 fix: data not received in drone
    [sketch_jul19a.ino]
2024-08-25 fix: remove volatile from flight mode
    [NewDrone.ino]
2024-08-25 feat: angle pid
2024-08-25 feat: velocity angular pid
2024-08-25 fix: remove variables unecessary
    [NewDrone.ino]
2024-08-25 fix: bug on modulador
    [NewDrone.ino]
2024-08-25 feat: emit engine pwm
2024-09-22 fix: reorder motors
2024-09-22 fix: comment setup mpu6050
    [NewDrone.ino]
2024-09-22 fix: reorder call functions
    [NewDrone.ino]
2024-09-22 fix: pid
2024-09-22 fix: invert min and max
    [sketch_jul19a.ino]
2024-11-15 fix: change esp 32 from drone
    [sketch_jul19a.ino]
2024-11-15 fix: pid not work correctly
    [NewDrone.ino]
2024-11-15 fix: new resolution and frequency
    [NewDrone.ino]
2024-11-15 fix: speed from engines not work
    [NewDrone.ino]
2024-11-15 fix: move code control to folder code
    [Control.ino]
2024-11-15 fix: rename newdrone to drone
    [Drone.ino]
2024-11-15 fix: change constants to uppercase
    [Drone.ino]
2024-11-15 fix: rename variable and variable channel
    [Drone.ino]
2024-11-16 fix: remove unecessary variable
    [Drone.ino]
2024-11-16 fix: remove code unecessary
    [Drone.ino]
2024-11-16 fix: remove unecessary variable speed
    [Drone.ino]
2024-11-16 fix: rename property speed to motorsSpeed
    [Drone.ino]
2024-11-16 fix: remove unecessary variable throttle
    [Drone.ino]
2024-11-16 fix: set the same type from control
    [Drone.ino]
2024-11-16 fix: move declaration to function
    [Drone.ino]
2024-11-16 fix: rename variables correctly
    [Drone.ino]
2024-11-16 fix: rename variables with pt in front
    [Drone.ino]
2024-11-16 fix: velocity break time cycle
    [Drone.ino]
2024-11-16 fix: add alert about velocities from motors
    [Drone.ino]
2024-11-16 feat: button work for joystick 1
2024-11-16 fix: pass variable wrong
    [Control.ino]
